opencarecc/rampette/procedura/interactive_prototype/assets/1b54cf49c1ea7b13547d7fd8180b078a.jpg

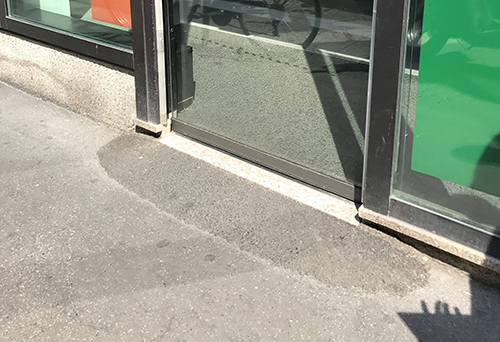
procedura/interactive_prototype/assets/1b54cf49c1ea7b13547d7fd8180b078a.jpg
