opencarecc/rampette/procedura/interactive_prototype/assets/a0a5a3e426ebfc1ea9eee80692e2d143.jpg

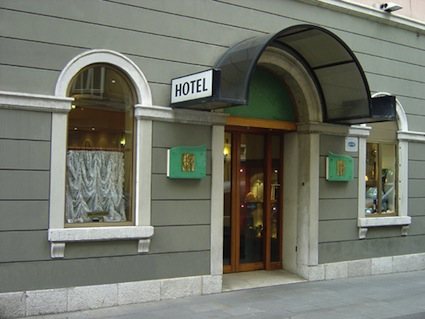
procedura/interactive_prototype/assets/a0a5a3e426ebfc1ea9eee80692e2d143.jpg
