opencarecc/rampette/README.md

# openrampette

This repo contain code, sketches, and hw design related to the open rampette project.

Filed inside the folder chiamata you will find prototypes of doorbells, beacons, stickers and apps to improve the experience of accessibility of a shop that does not have a permanent wheelchair ramp.

Filed inside the folder procedura you will find prototypes and code with the goal to improve the experience of a shop owner that has to certify his shop as "accessible".

The project is ongoing. Interested in contributing? drop us a line opencare@wemake.cc

n.b the website and the instructions on how to run it are in the **gh-pages** branch :)
