opencarecc/rampette/chiamata/iteration1/PROTOTYPES/1.a_m(app)atura/README.md

# 1.a An app to discover accessible shops in the city

**app features:**
- Show accessible shops in town
- Let user review and rate the shops

See the pdf of the prototype in the folder.
