opencarecc/rampette/chiamata/iteration1/PROTOTYPES/3.a_campanello/README.md

# 3.a A doorbell(that can be ring also by pulling a rope) that gives feedback to the user

Find in the folder the Arduino sketch and the cutting files to reproduce the design.
