opencarecc/rampette/chiamata/iteration1/PROTOTYPES/3.b_beacon/README.md

3.b A doorbell (fitted with ibeacon technology) that advertizes the presence of an accessible shop and allows the user to call for assistance with his own smartphone

Find in the folder the code of the app, based on ionic framework, and the arduino sketches used for emulating a beacon and advertising the GATT profile.

The microbit code was tested and works.
The porting of the code on adafruit feather is still ongoing.
