opencarecc/rampette/chiamata/iteration1/PROTOTYPES/3.c_device/README.md

# 3.c A custom device that understands (via bluetooth e beacon) when it is close to the shop and can be used to call for assistance

In the folder find the Arduino code to emulate a button and asyng leds animations.
