opencarecc/rampette/chiamata/iteration1/PROTOTYPES/4.b_smartphone/README.md

# 4.b Receive the doorbell call on your smartphone.

This prototype was not developed during the first sprint.
