opencarecc/rampette/chiamata/iteration2/receiver/receiver01.jpg

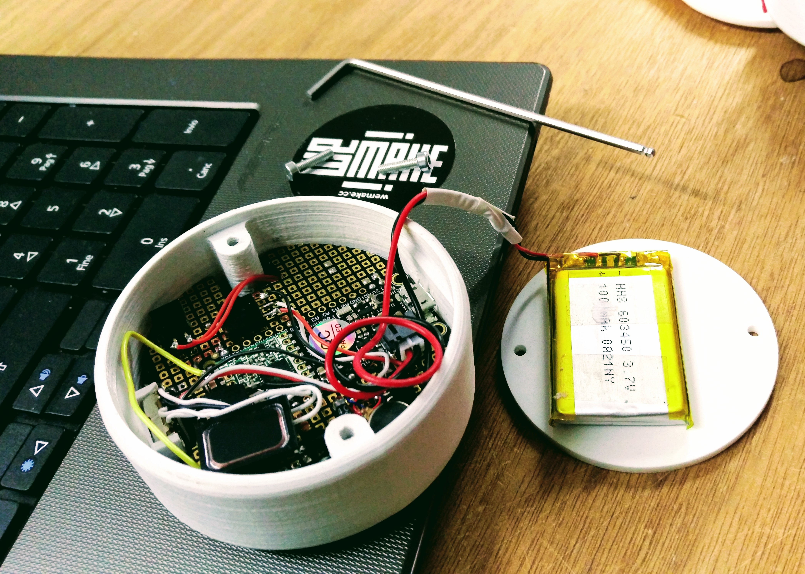
chiamata/iteration2/receiver/receiver01.jpg
