opencarecc/rampette/chiamata/iteration2/receiver/receiver.png

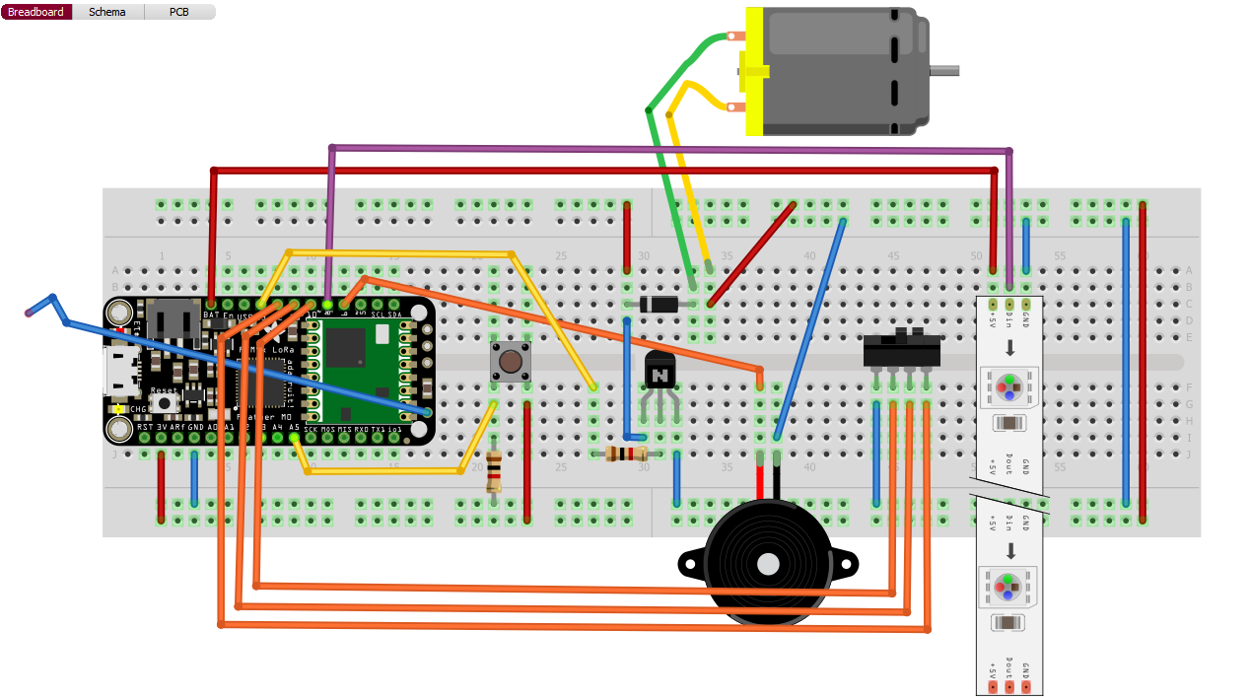
chiamata/iteration2/receiver/receiver.png
