opencarecc/rampette/chiamata/iteration2/receiver/ricevitore.png

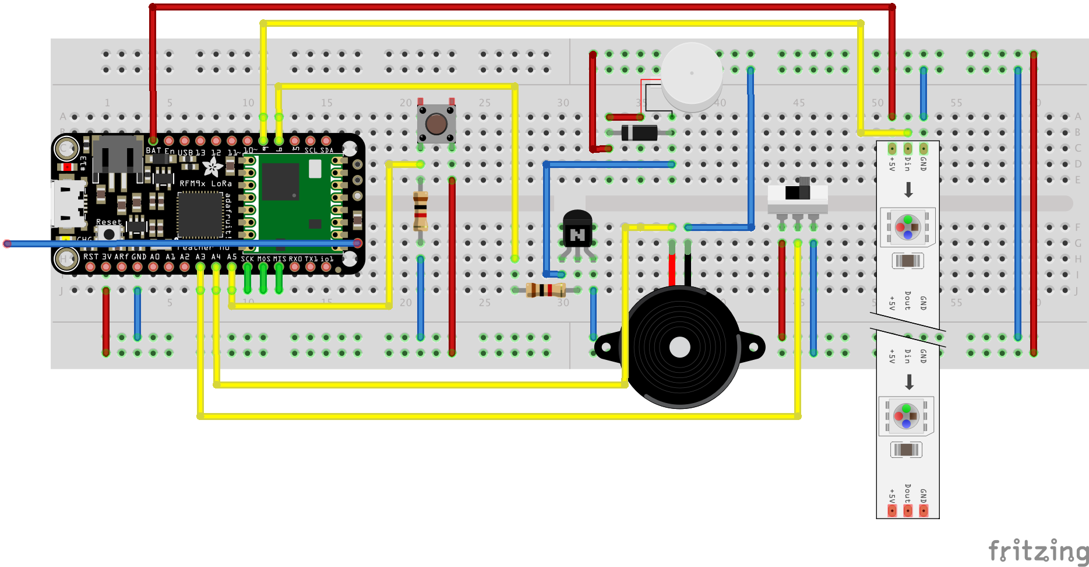
chiamata/iteration2/receiver/ricevitore.png
