opencarecc/rampette/chiamata/iteration2/receiver/transm-receiv.jpg

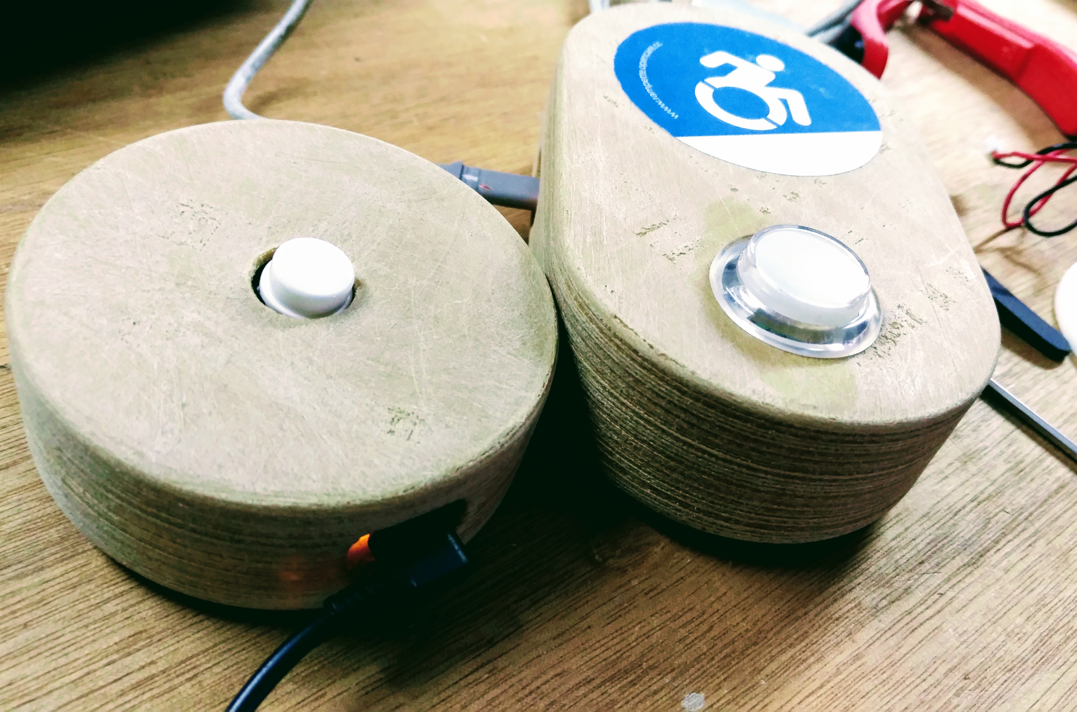
chiamata/iteration2/receiver/transm-receiv.jpg
