opencarecc/rampette/chiamata/iteration2/trasmitter/campanello_schematics.png

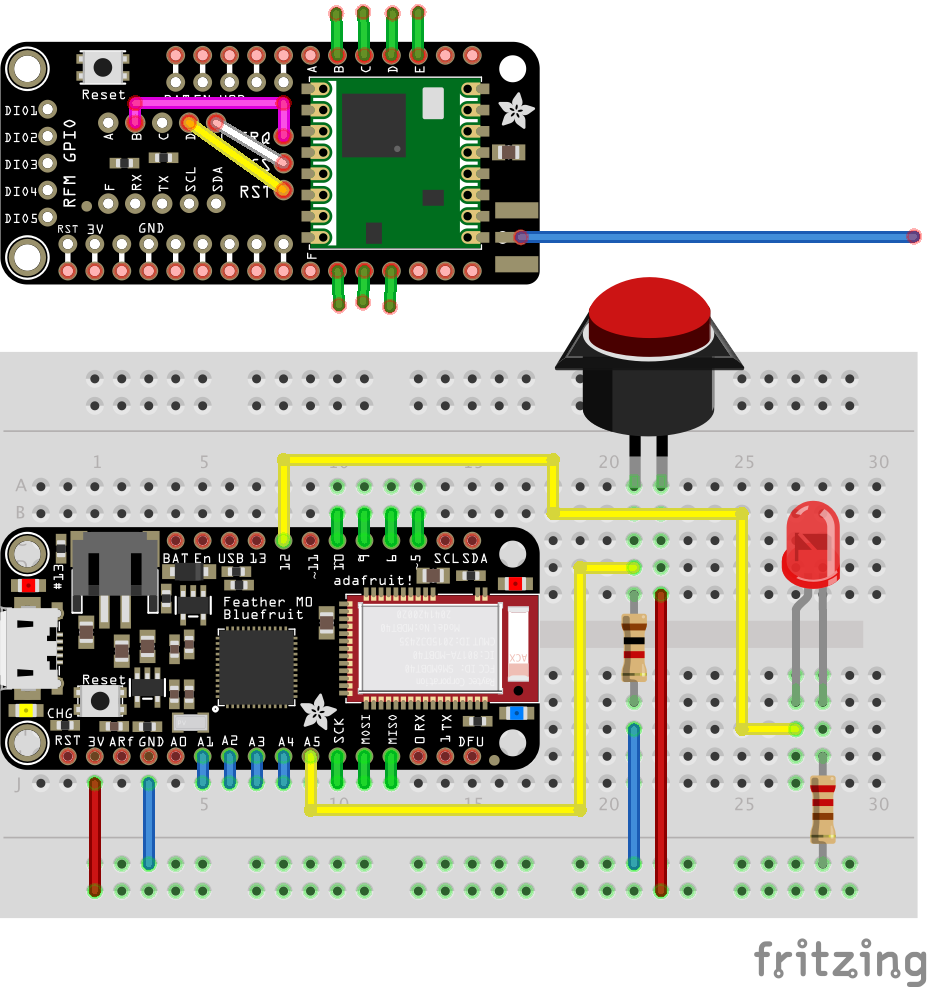
chiamata/iteration2/trasmitter/campanello_schematics.png
