opencarecc/rampette/chiamata/iteration2/trasmitter/transmit02.jpg

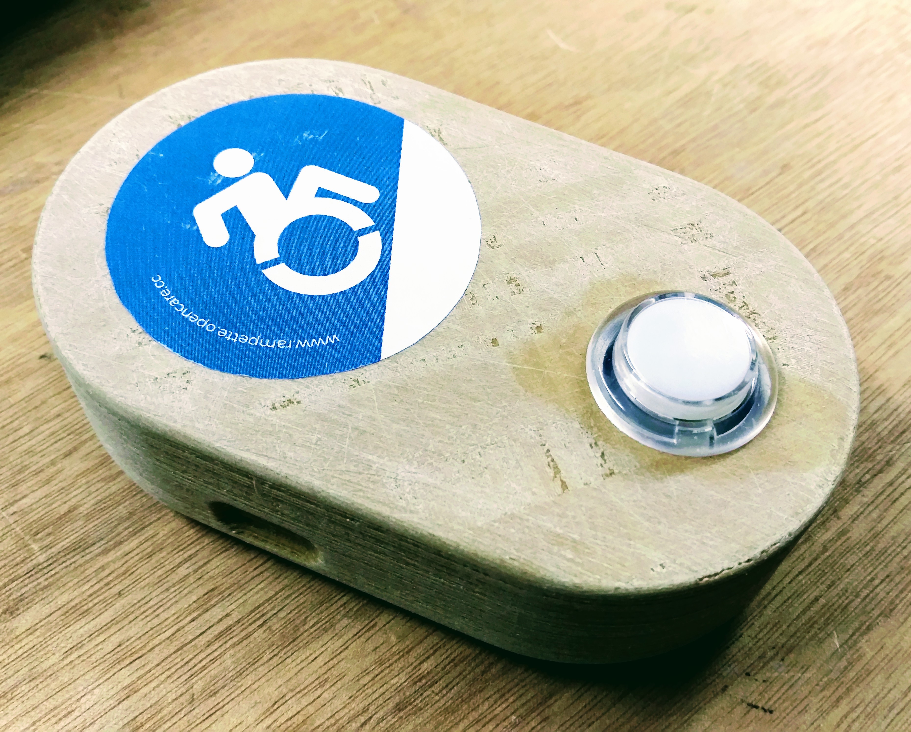
chiamata/iteration2/trasmitter/transmit02.jpg
