opencarecc/rampette/chiamata/iteration2/trasmitter/transmit03.jpg

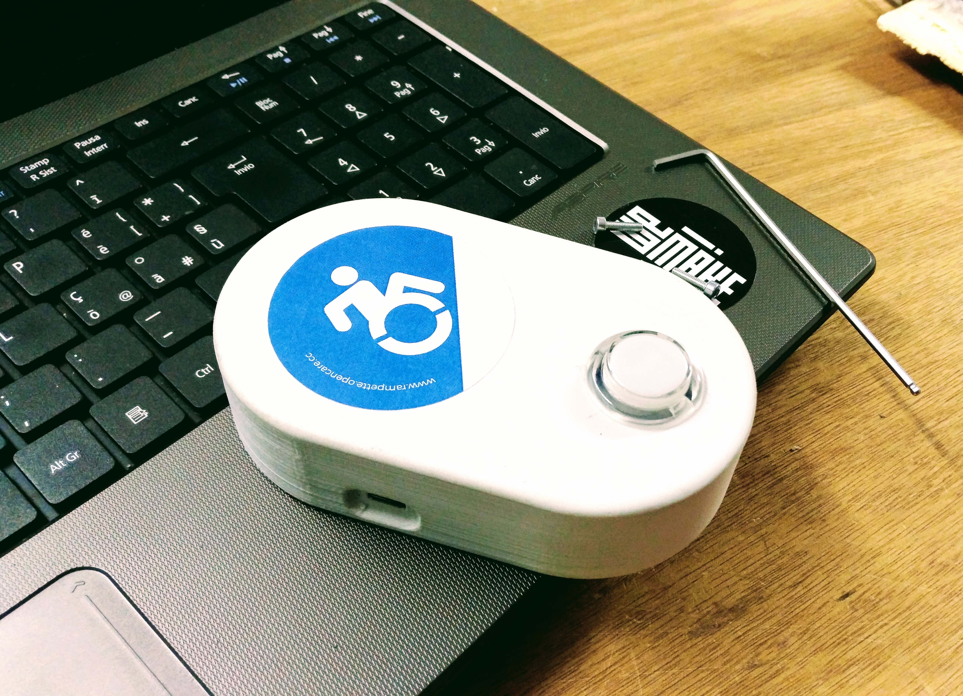
chiamata/iteration2/trasmitter/transmit03.jpg
