opencarecc/rampette/chiamata/iteration2/trasmitter/transmit04.jpg

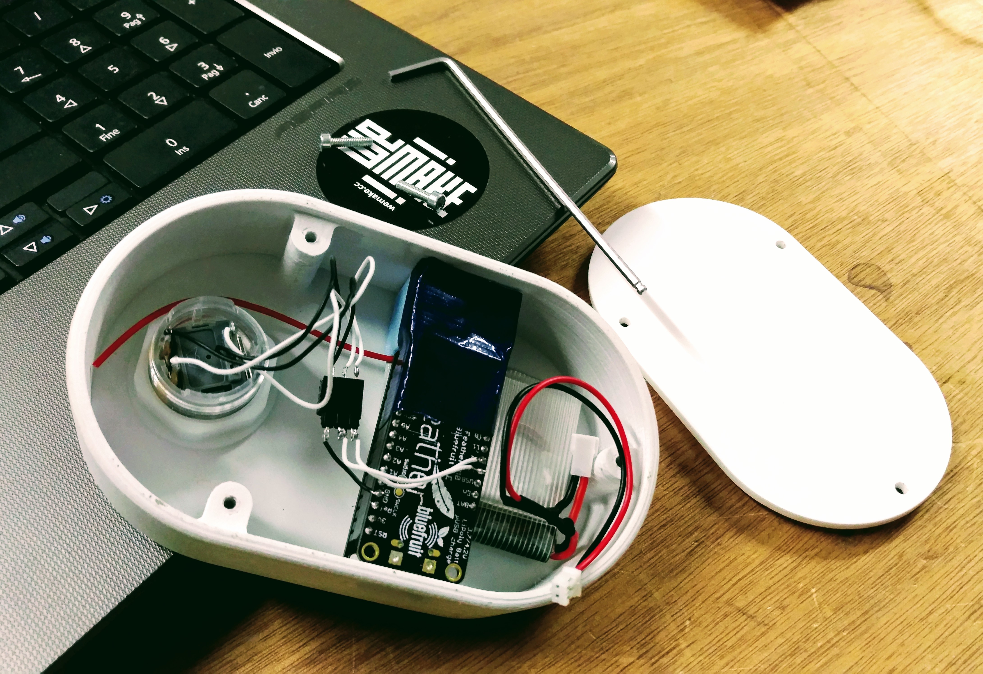
chiamata/iteration2/trasmitter/transmit04.jpg
