opencarecc/rampette/chiamata/iteration2/trasmitter/transmitter.png

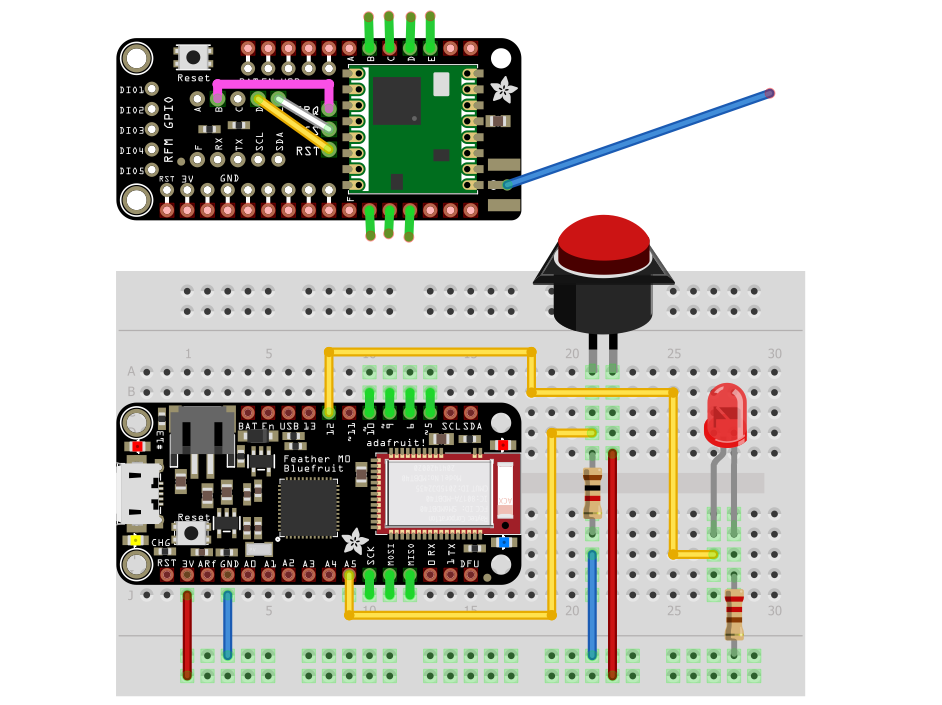
chiamata/iteration2/trasmitter/transmitter.png
