opencarecc/rampette/comunicazione/sticker-final-giga.png

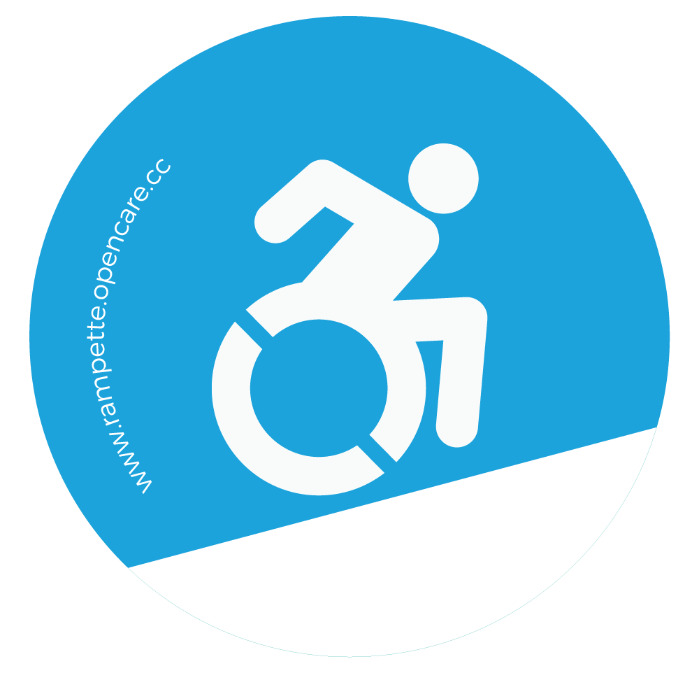
comunicazione/sticker-final-giga.png
