opencarecc/rampette/procedura/interactive_prototype/assets/5c6078fb97a639b11d2d07bfd023e27d.jpg

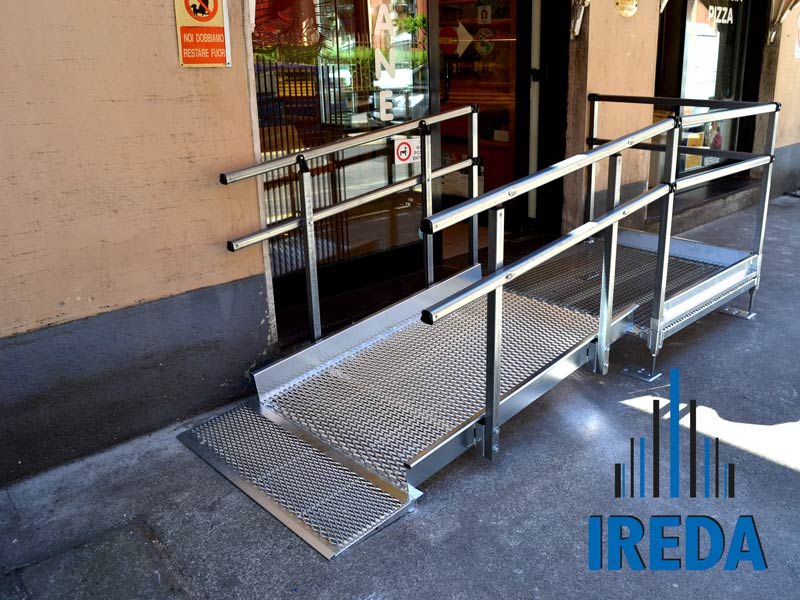
procedura/interactive_prototype/assets/5c6078fb97a639b11d2d07bfd023e27d.jpg
