opencarecc/rampette/procedura/interactive_prototype/assets/61b61386fad17b450ef703ad73e63b27.jpg

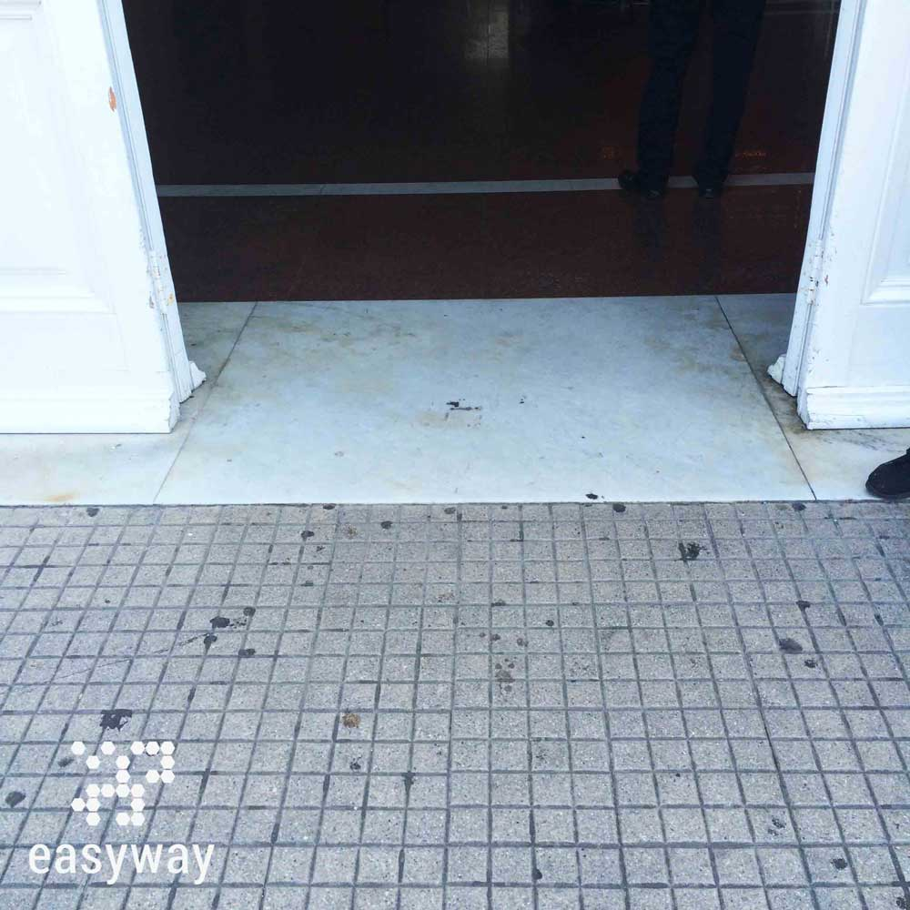
procedura/interactive_prototype/assets/61b61386fad17b450ef703ad73e63b27.jpg
