opencarecc/rampette/procedura/interactive_prototype/assets/69d8bbbff6ce369b452d7309668e4553.png

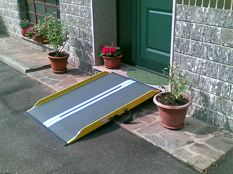
procedura/interactive_prototype/assets/69d8bbbff6ce369b452d7309668e4553.png
