opencarecc/rampette/procedura/interactive_prototype/assets/654516a93ae3e7a3db9a210ed372432e.gif

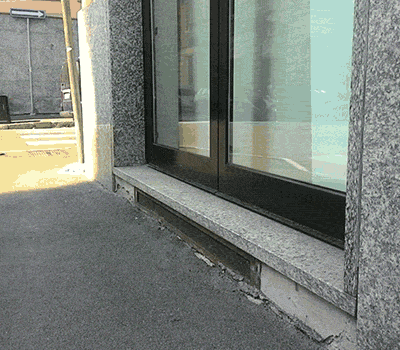
procedura/interactive_prototype/assets/654516a93ae3e7a3db9a210ed372432e.gif
