opencarecc/rampette/procedura/interactive_prototype/assets/1265800e9a697635cb029c5c4eaa31cd.jpg

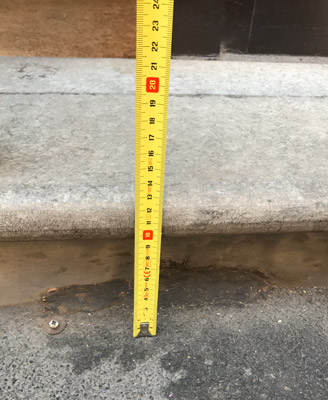
procedura/interactive_prototype/assets/1265800e9a697635cb029c5c4eaa31cd.jpg
