opencarecc/rampette/procedura/interactive_prototype/assets/bf159e45600adaa4f7dddba2ecc5b0aa.png

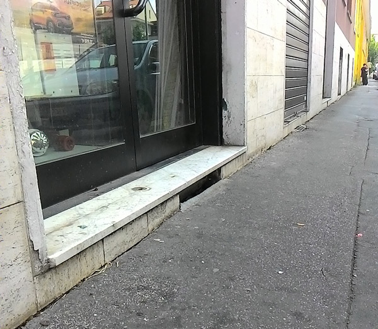
procedura/interactive_prototype/assets/bf159e45600adaa4f7dddba2ecc5b0aa.png
