opencarecc/rampette/procedura/interactive_prototype/assets/f8df2b80d41db855c14166372235f77a.jpg

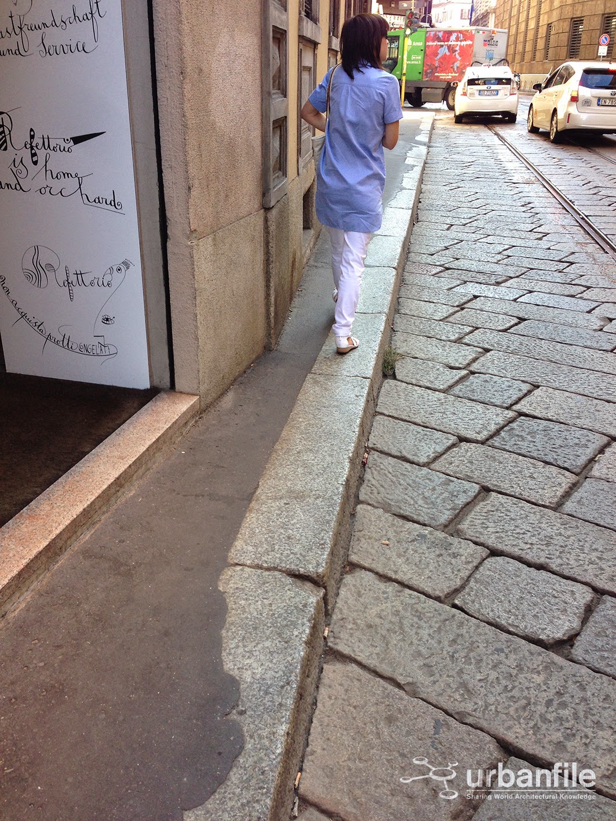
procedura/interactive_prototype/assets/f8df2b80d41db855c14166372235f77a.jpg
