opencarecc/rampette/chiamata/iteration2/receiver/3d model and fabrication file/receiver back.dxf

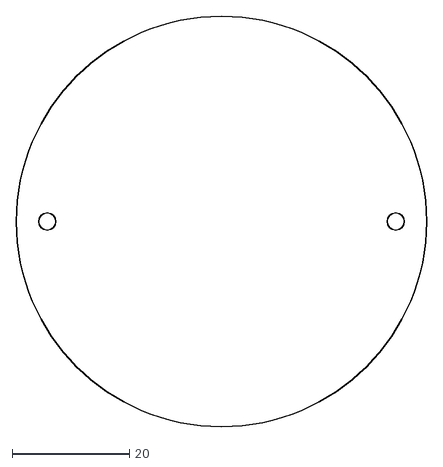
[picture p20: CAD file, 2017-11-13]
chiamata/iteration2/receiver/3d model and fabrication file/receiver back.dxf
70.0 x 70.0
