opencarecc/rampette/chiamata/iteration2/trasmitter/3d model and fabrication file/transmitter back.dxf

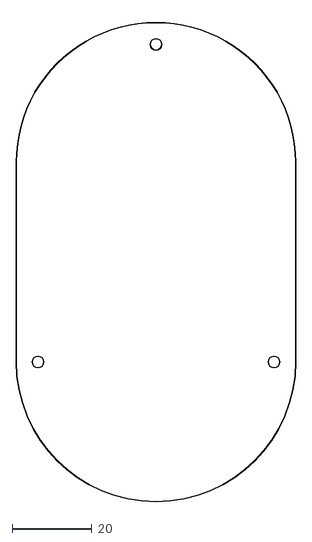
[picture p21: CAD file, 2017-11-13]
chiamata/iteration2/trasmitter/3d model and fabrication file/transmitter back.dxf
70.0 x 121.6
