opencarecc/rampette/chiamata/iteration2/trasmitter/3d model and fabrication file/transmitter.stl

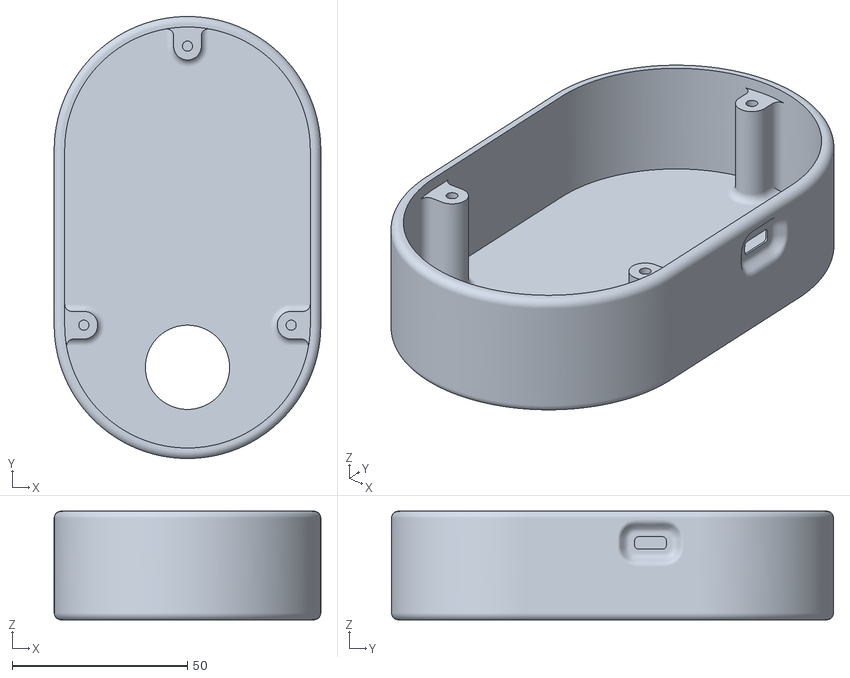
[picture p22: CAD file, 2017-11-12]
chiamata/iteration2/trasmitter/3d model and fabrication file/transmitter.stl
76.0 x 126.0 x 31.0
