opencarecc/rampette/chiamata/iteration1/PROTOTYPES/3.a_campanello/cutting_files/modelli prototipi.dxf

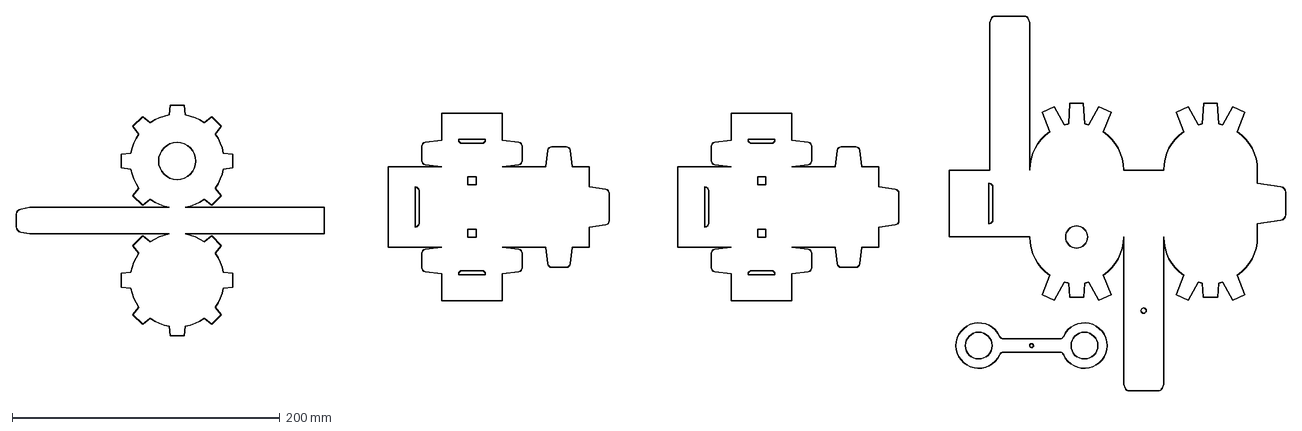
[picture p23: CAD file, 2017-06-28, an earlier design]
chiamata/iteration1/PROTOTYPES/3.a_campanello/cutting_files/modelli prototipi.dxf
947.9 x 280.0 mm
