opencarecc/rampette/(list of files, cad)

Other CAD files:
chiamata/iteration2/receiver/3d model and fabrication file/receiver.3dm
chiamata/iteration2/trasmitter/3d model and fabrication file/transmitter.3dm
