opencarecc/rampette/chiamata/iteration2/instructions/manual_openrampette.pdf

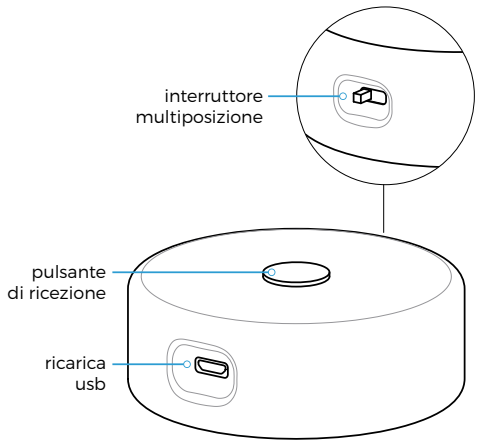
[picture p24: figure]
interruttore multiposizione; pulsante di ricezione; ricarica usb

## open

### rampette

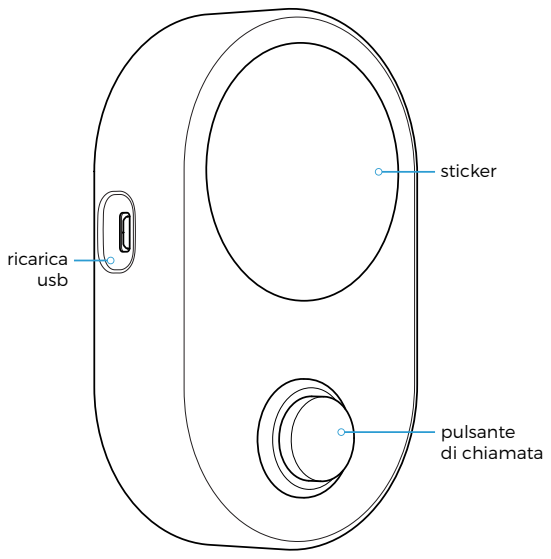
[picture p25: figure]
pulsante di chiamata; sticker; ricarica usb

# CAMPANELLO RICEVITORE

DOVE POSIZIONARE /
il campanello va installato all’esterno del negozio, di fianco all’entrata, a un’altezza da terra di 1 m ± 10 cm.

COME IMPOSTARE /
l’interruttore a 3 posizioni permette di impostare il tipo di notifica che si vuole ricevere:

### 1 luce 2 luce + vibrazione 3 luce + suono + vibrazione

DOVE POSIZIONARE /
il ricevitore è un dispositivo wireless e non ha bisogno di essere fissato, può essere collocato in una zona visibile del negozio (es. bancone) o essere portato in tasca.

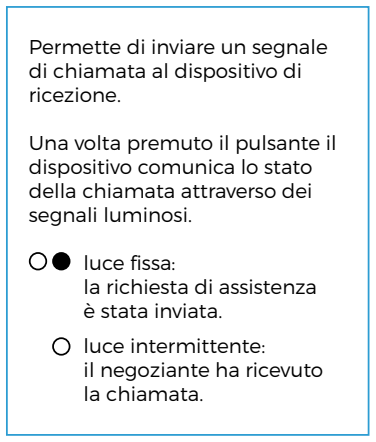
[picture p26: figure]
Permette di inviare un segnale di chiamata al dispositivo di ricezione.; Una volta premuto il pulsante il dispositivo comunica lo stato della chiamata attraverso dei segnali luminosi.; luce fissa: la richiesta di assistenza è stata inviata. luce intermittente: il negoziante ha ricevuto la chiamata.

COME FISSARE /
applicare del nastro biadesivo sul retro del dispositivo e farlo aderire al muro facendo pressione.

Permette al negoziante di
essere notificato quando
qualcuno richiede assistenza dall’esterno del negozio.

Può emettere un segnale
luminoso / sonoro / di vibrazione.

Il pulsante di ricezione permette di notificare l’utente che ha effettuato la chiamata all’esterno che la richiesta di assistenza è stata ricevuta.

TEST | 1 Premere il pulsante del campanello e verificare che il ricevitore di chiamata emetta il segnale stabilito. 2 Premere il pulsante del ricevitore e verificare che la luce del campanello da intermittente diventi fissa

## REGISTRAZIONE

| Registra la tua attività commerciale su www.rampette.opencare.cc/registra Entra a far parte della rete dei negozi accessibili del Comune di Milano e permetti a tutti di trovarti tramite app.
1 | 2 | 3

1 m
