opencarecc/rampette/chiamata/iteration2/instructions/2017-11-14_170640.png

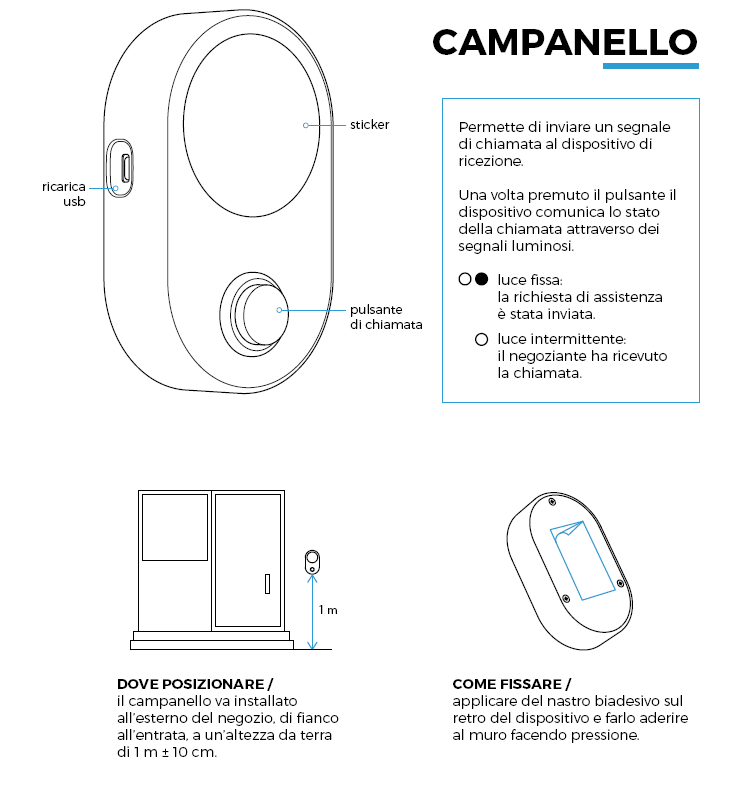
chiamata/iteration2/instructions/2017-11-14_170640.png
