opencarecc/rampette/chiamata/iteration2/instructions/2017-11-14_170655.png

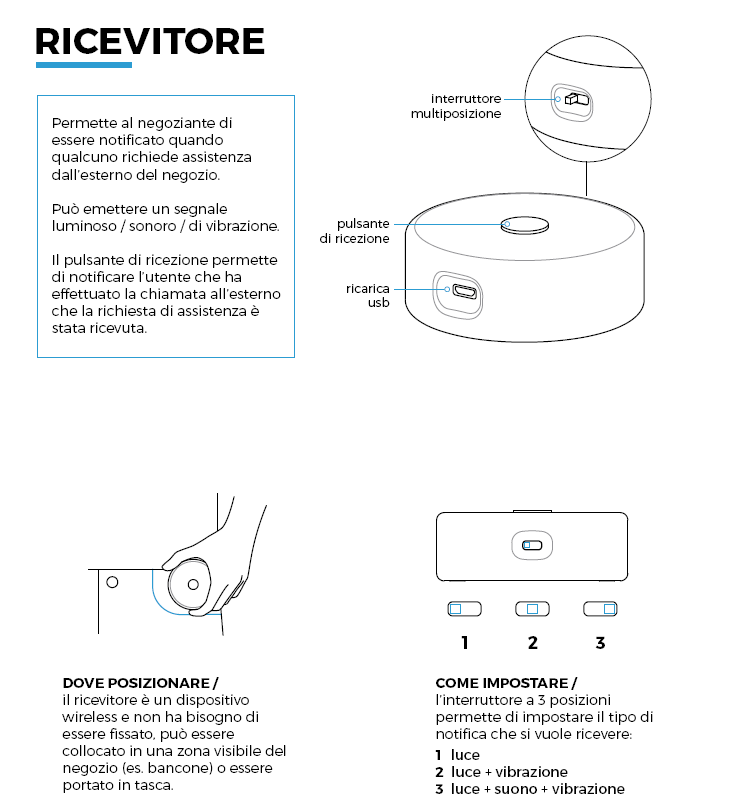
chiamata/iteration2/instructions/2017-11-14_170655.png
