opencarecc/rampette/chiamata/iteration1/PROTOTYPES/2.a_sticker/_sticker.pdf

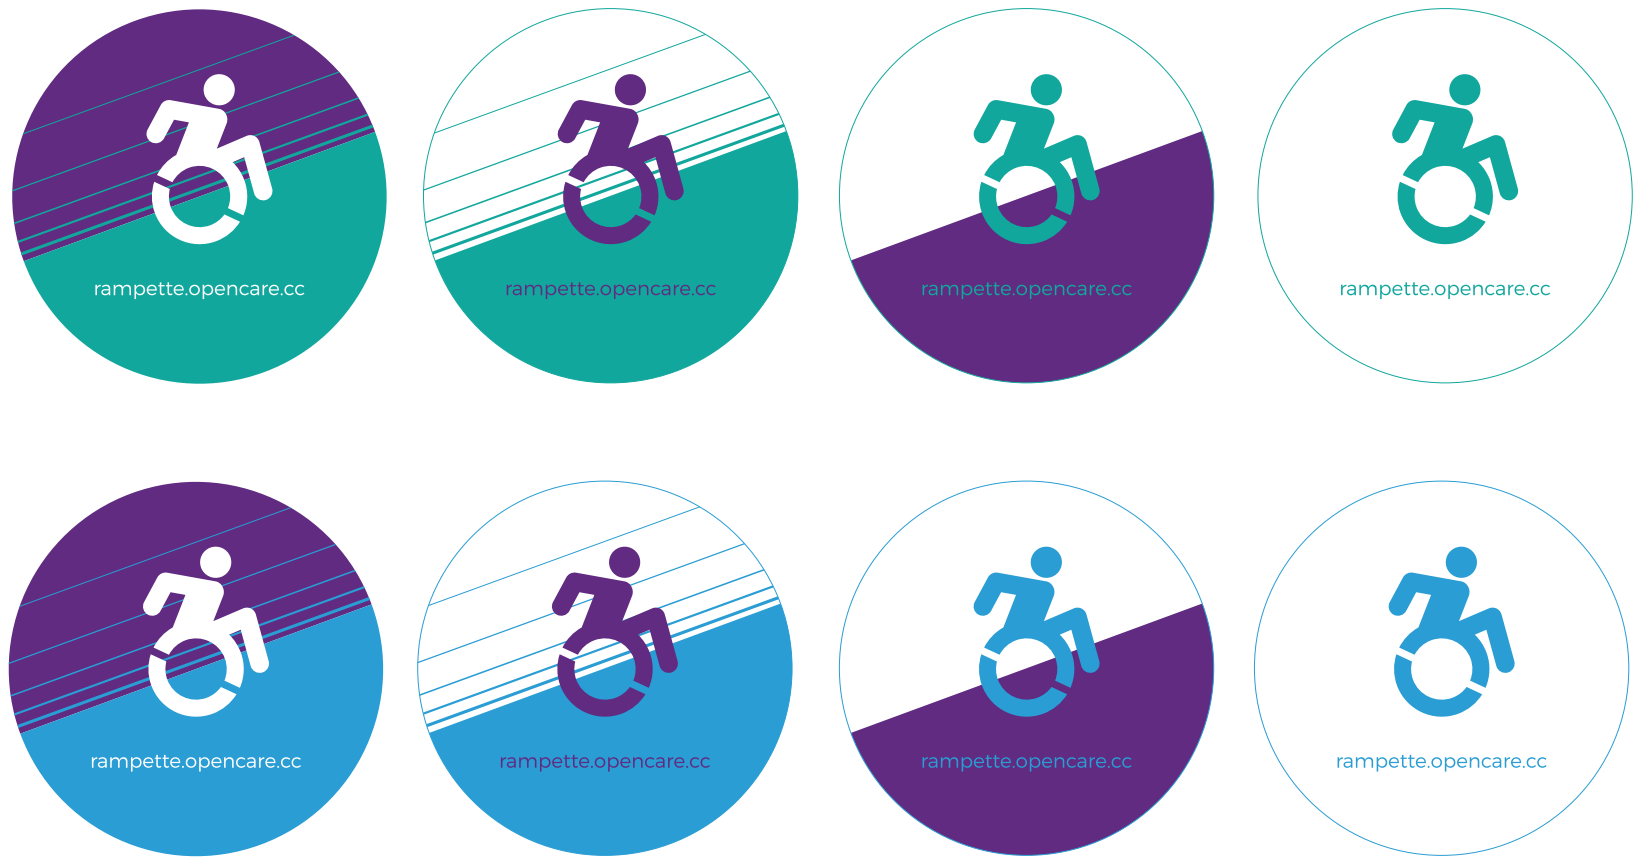
[picture p29: page 1]

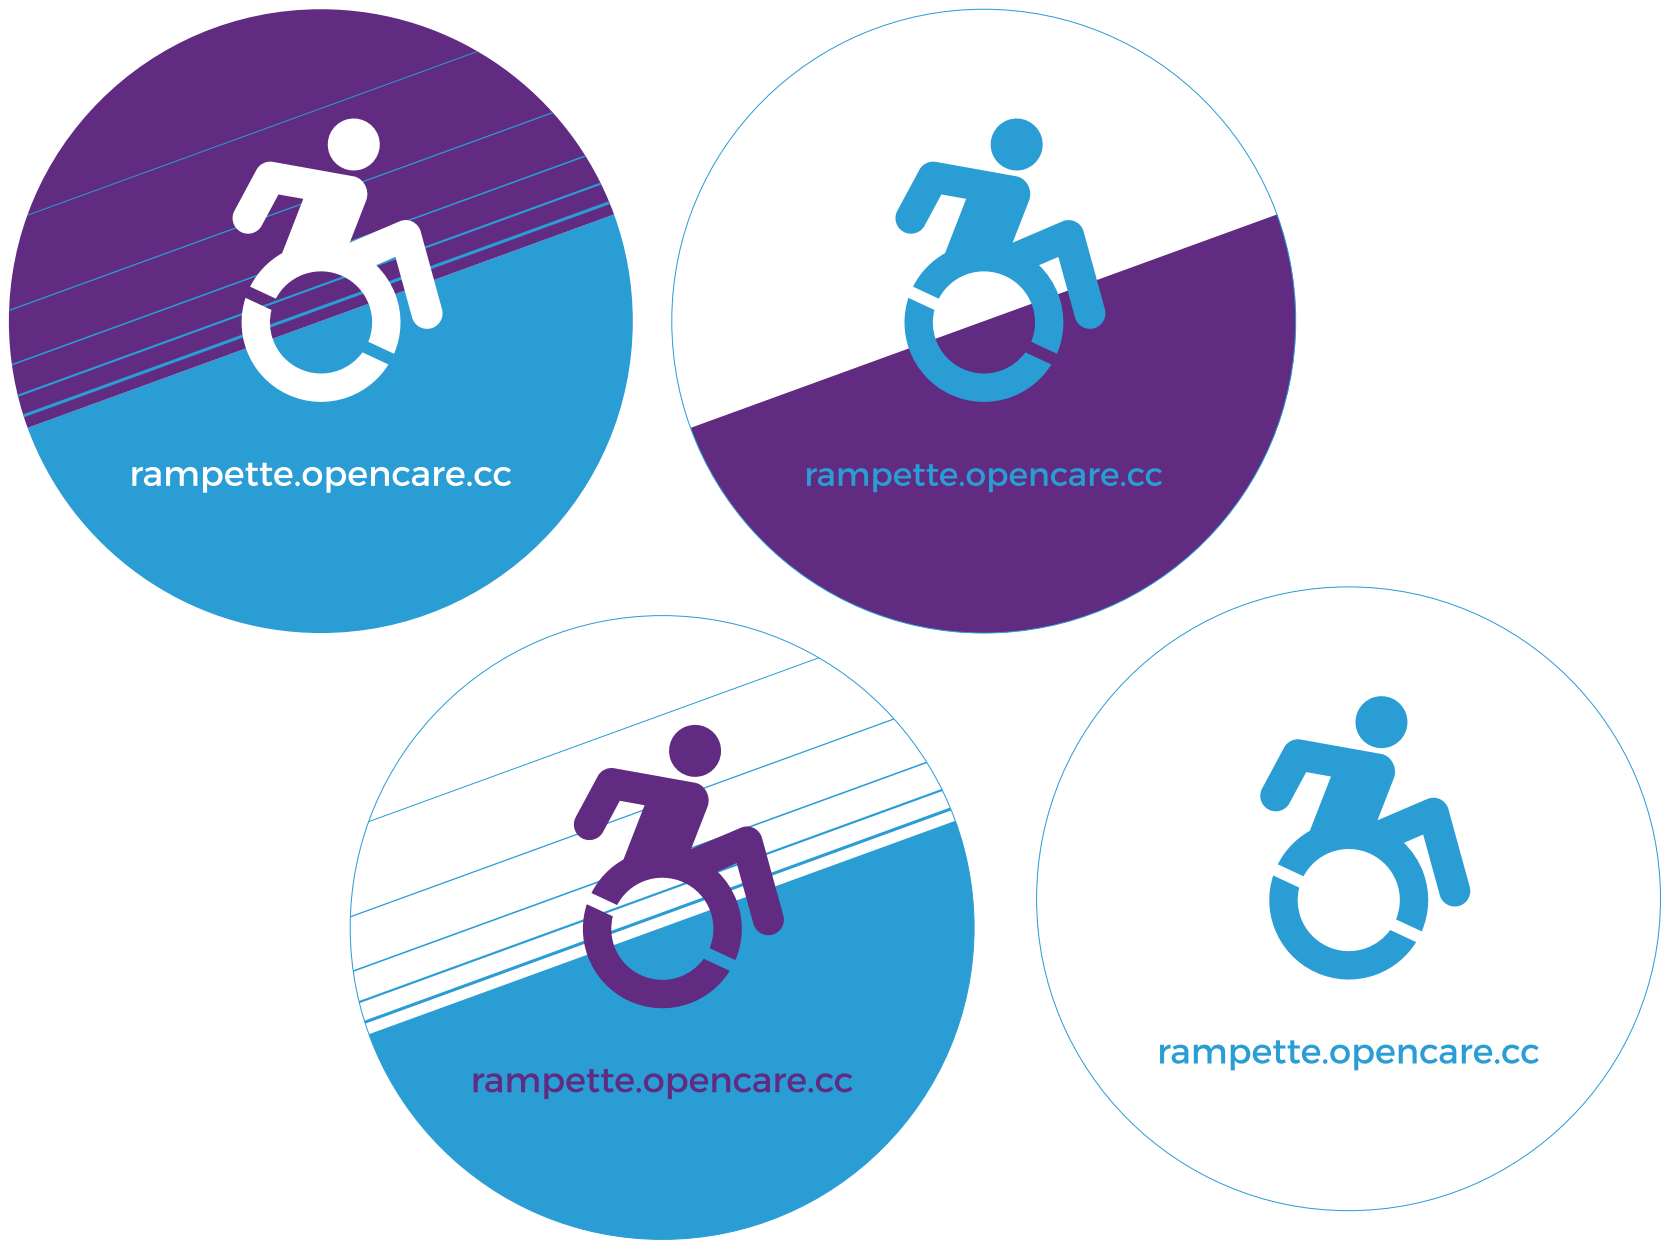
[picture p30: page 2]
