opencarecc/rampette/(list of files, drawings)

Other design files:
chiamata/iteration2/receiver/ricevitore.fzz
chiamata/iteration2/trasmitter/campanello.fzz
