opencarecc/rampette/(commit log)

2017-06-15 added readme to all prototypes
2017-06-28 added cutting files
    [modelli prototipi.dxf]
2017-07-05 added fritzing
    [campanello.fzz, ricevitore.fzz]
2017-07-05 rearranged folders and copied app
    [campanello.fzz, ricevitore.fzz]
2017-07-17 rearranged folder content and tested with wired prototypes
    [campanello.fzz, ricevitore.fzz]
2017-07-18 fixed two way communication
    [lora.ino, loraTestReceiver.ino, loraTestTrasmitter.ino, utils.ino]
2017-07-18 added some ble stuff - need to check if value are being sent from board to app
2017-07-19 final fixes to button link
    [loraTestReceiver.ino, loraTestTrasmitter.ino, utils.ino]
2017-07-20 final code uploaded on devices
2017-07-20 added lib folder
    [project.cfg]
2017-07-25 adding new images and correct shops info
    [BLE.ino, NeoPatterns.h, breadboardProtoReceiver.ino, breadboardProtoTrasmitter.ino, lora.ino, utils.ino]
2017-07-26 Add nomi negozi dove sono i device
2017-07-27 add procedura prototype
2017-11-12 receiver 3d model
    editable .3dm file of receiver case and .stl ready to print
    [receiver.3dm]
2017-11-12 transmitter 3d model
    editable .3dm file of transmitter case and .stl ready to print
    [transmitter.3dm, transmitter.stl]
2017-11-13 receiver back cap
    dxf for lasercut of receiver back cap
    [receiver back.dxf]
2017-11-13 transmitter back cap
    dxf for lasercut of transmitter back cap
    [transmitter back.dxf]
2017-11-13 change folder name
    [transmitter back.dxf, transmitter.3dm, transmitter.stl]
